LucaVLR/SmartSystems/README.md

# SmartSystems

## Bekijk de analyse hier:
[Analyse](./Analyse.md)

## Bekijk de eind documentatie hier:
[Documentatie](./Documentatie.md)
