LucaVLR/SmartSystems/NodeRED/README.md

Bevat alle NodeRED flows om de Smartcar aan te sturen via een dashboard
