LucaVLR/SmartSystems/SmartCarDrive/README.md

Bevat het programma voor het ESP bordje om de smartcar aan te sturen.
