LucaVLR/SmartSystems/ATSense/README

Bevat de software voor het ATSense bordje
