LucaVLR/SmartSystems/Afbeeldingen/README.md

Deze folder bevat alle afbeeldingen die gebruikt worden in de documentatie
