LucaVLR/SmartSystems/(commit log)

2022-04-29 Flowcharts en diagrams toegevoegd
2022-04-29 Diagramma en flowcharts added
2022-04-29 Schema's en pcbs toegevoegd
